openspaceaarhus/HAL900/door-ctrl/hardware-4/doorctrl-v4-rfid.sch

## KiCad design door-ctrl/hardware-4/doorctrl-v4-rfid.sch (2021-06-15)

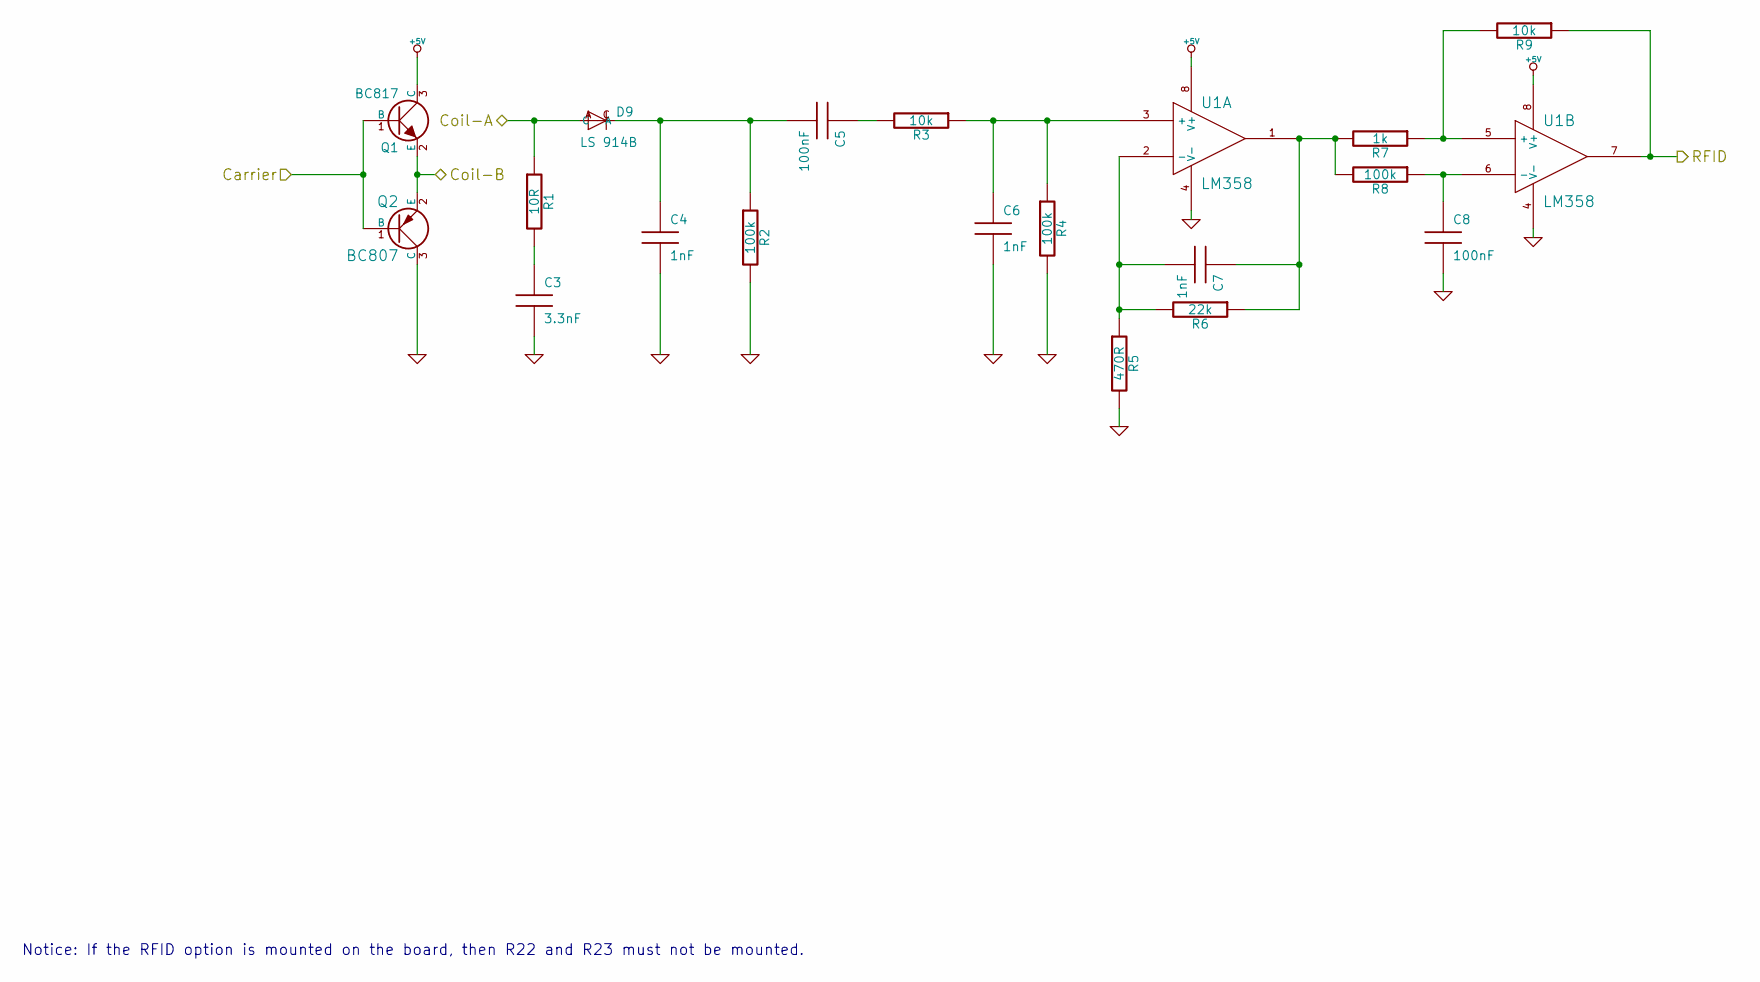
[picture p5: schematic doorctrl-v4-rfid.sch]

Parts:
C3: 3.3nF
C4, C6, C7: 1nF
C5, C8: 100nF
D9: LS 914B; diode-MINIMELF
Q1: BC817
Q2: BC807
R1: 10R
R2, R4, R8: 100k
R3, R9: 10k
R5: 470R
R6: 22k
R7: 1k
U1: LM358

Connections:
+5V: Q1.3 (C), U1.8 (V+)
Carrier: Q1.1 (B), Q2.1 (B)
Coil-A: D9.A, R1.1
Coil-B: Q1.2 (E), Q2.2 (E)
GND: C3.2, C4.2, C6.2, C8.2, Q2.3 (C), R2.2, R4.2, R5.2, U1.4 (V-)
unnamed: C3.1, R1.2
unnamed: C4.1, C5.2, D9.C, R2.1
unnamed: C5.1, R3.2
unnamed: C6.1, R3.1, R4.1, U1.3 (+)
unnamed: C7.1, R6.1, R7.2, R8.2, U1.1
unnamed: C7.2, R5.1, R6.2, U1.2 (-)
unnamed: C8.1, R8.1, U1.6 (-)
unnamed: R7.1, R9.2, U1.5 (+)
RFID: R9.1, U1.7

Notes on the sheet:
Notice: If the RFID option is mounted on the board, then R22 and R23 must not be mounted.
