openspaceaarhus/HAL900/door-ctrl/firmware2021/events.h

#pragma once

#include <stdint.h>
#include "wiegand.h"

void event(uint8_t type, uint8_t *data, uint8_t dataSize);
void powerUpEvent(void);
void wiegandInput(struct WiegandData *data);
void controlTokenEvent(uint32_t *token);
void controlStateEvent(uint8_t state);

uint8_t popEvents(uint8_t skipOlder, uint8_t *buffer, uint8_t maxBytes);
