openspaceaarhus/HAL900/door-ctrl/atmega8/uart.h

#pragma once

#include <stdio.h>
#include <avr/pgmspace.h>

#define P(format, ...) printf_P(PSTR(format), ##__VA_ARGS__)
#define L(str) puts_P(PSTR(str))

void	uartInit(void);

void uartPutByte(uint8_t c);
void uartAwaitTxIdle(void);
int uart_getchar(FILE *stream);
