openspaceaarhus/HAL900/(commit log)

2019-11-25 Switched to bcrypt, because it's embarrassing to used salted sha256 in this day and age, hashes are upgraded automagically when it's being verified
2021-06-15 Starting out on the new firmware
    [doorctrl-rs485.sch, doorctrl-v4-gpio.sch, doorctrl-v4-net.sch, doorctrl-v4-psu.sch, doorctrl-v4-rfid.sch, doorctrl-v4.sch]
2021-06-23 Implemented a true random number generator using a BC547 based noise genearator on an ADC port
    [Main.java]
2021-06-26 Local device state storage now works
2021-06-26 Wiegand works when using the correct port
    [events.c, main.c, wiegand.c]
2021-06-27 Tuned the led timer to 1000 Hz
2021-06-28 Sync of rfid+pin from HAL now works
2021-06-28 Started GPIO support and broke something
    [events.c, events.h, frame.c, frame.h, leds.c, main.c]
2021-07-02 Switched to proper yaml for the export of hal state
2021-07-02 Implemented storing the device state in hal too
2021-09-14 Do not export rfids without a pin
2021-09-21 Set order of transactions in account page.
    The order of transactions is now based on created date, rather than
    transaction id. This allow us to make back-dated transactions, if
    needed.
    Such transactions can currently only be created by hand, but if we need
    this more often, we can create an interface for it.
2021-11-09 Added ability to disable access devices
